Gab-Flores/OTW_FUTUREENGINEERS2025/Team Photos/Team Shot3.jpg

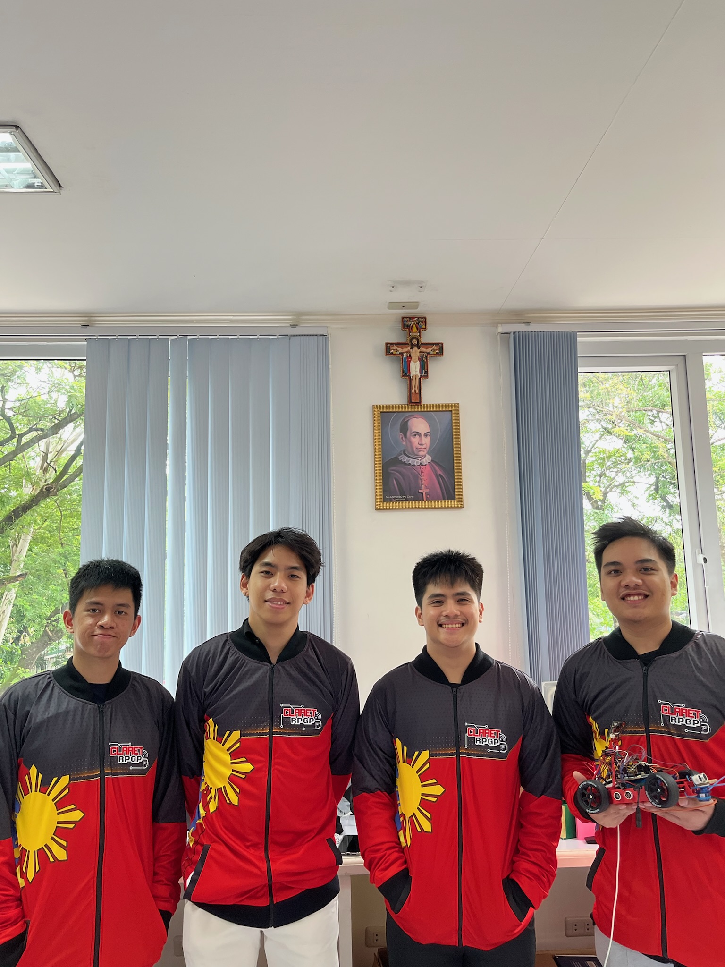
Team Photos/Team Shot3.jpg
