Gab-Flores/OTW_FUTUREENGINEERS2025/Vehicle Photos/Back.jpg

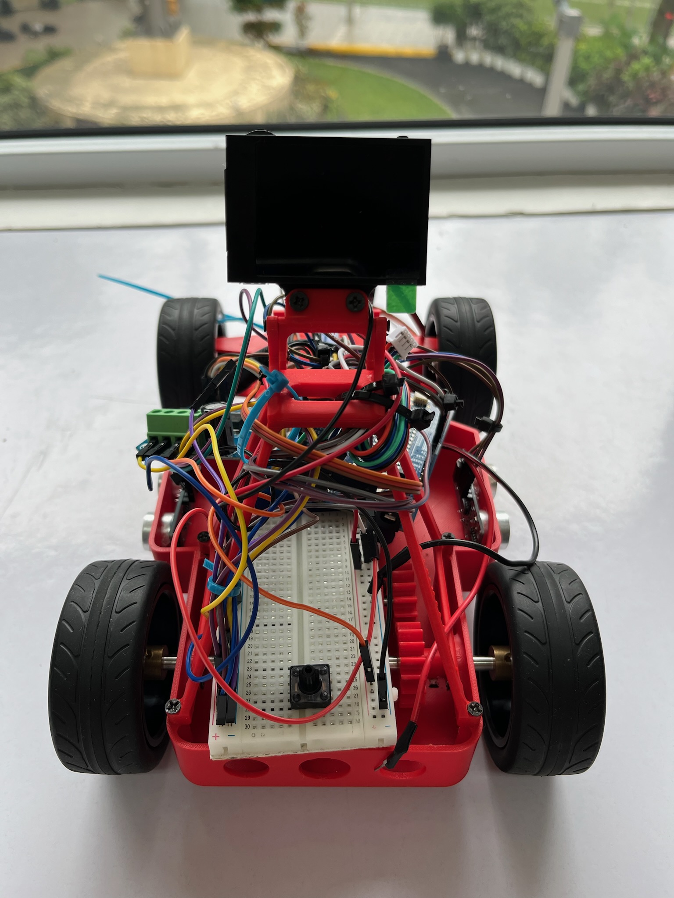
Vehicle Photos/Back.jpg
