Gab-Flores/OTW_FUTUREENGINEERS2025/Schemes/Circuit Diagram Team OTW.png

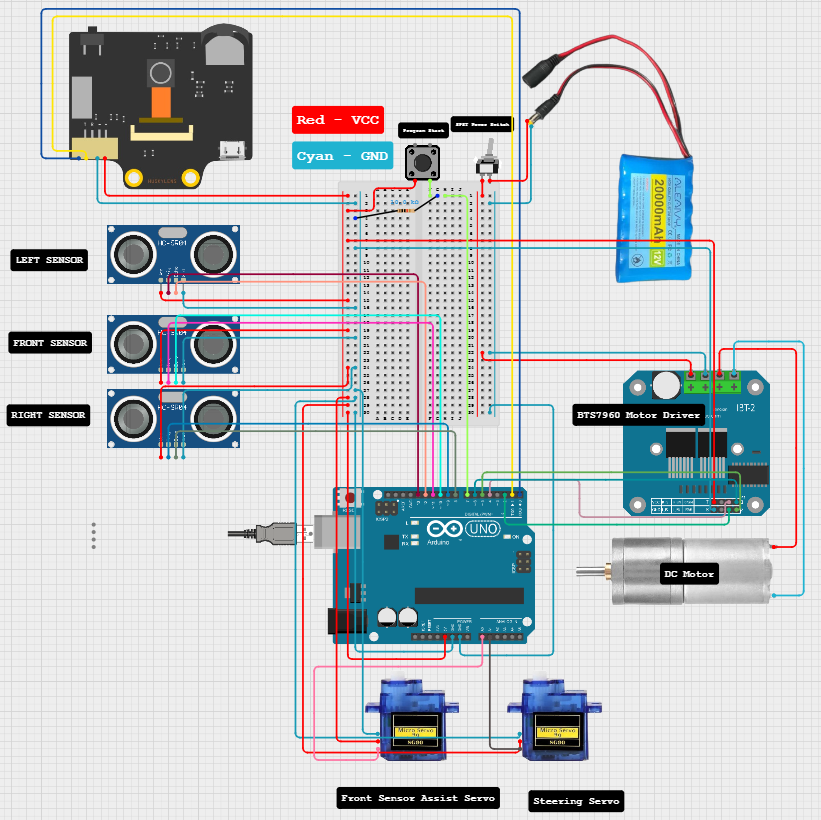
Schemes/Circuit Diagram Team OTW.png
