Gab-Flores/OTW_FUTUREENGINEERS2025/Team Photos/Funny Shot.jpg

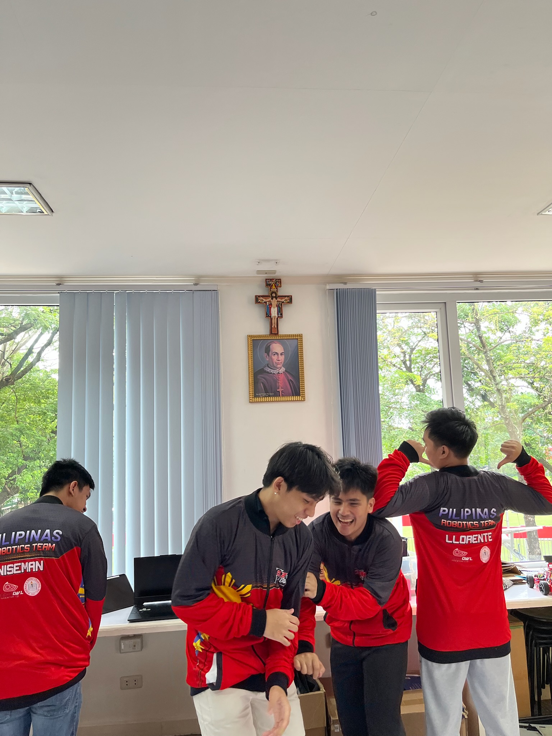
Team Photos/Funny Shot.jpg
