Gab-Flores/OTW_FUTUREENGINEERS2025/Team Photos/Team Shot1.jpg

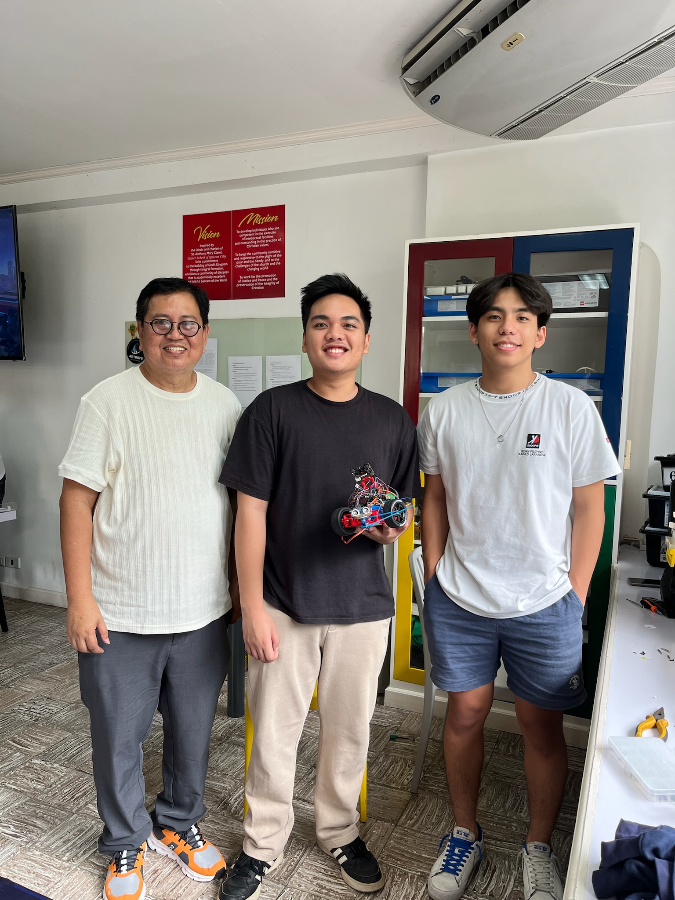
Team Photos/Team Shot1.jpg
