Gab-Flores/OTW_FUTUREENGINEERS2025/Team Photos/Team Shot2.jpg

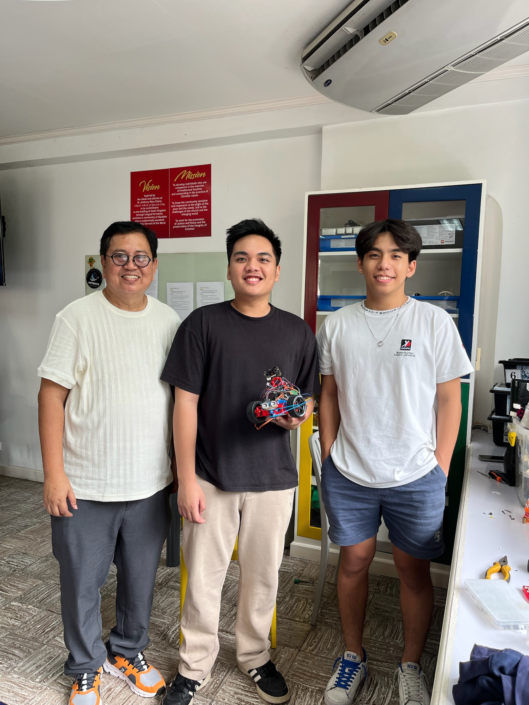
Team Photos/Team Shot2.jpg
