Gab-Flores/OTW_FUTUREENGINEERS2025/Vehicle Photos/Bottom.jpg

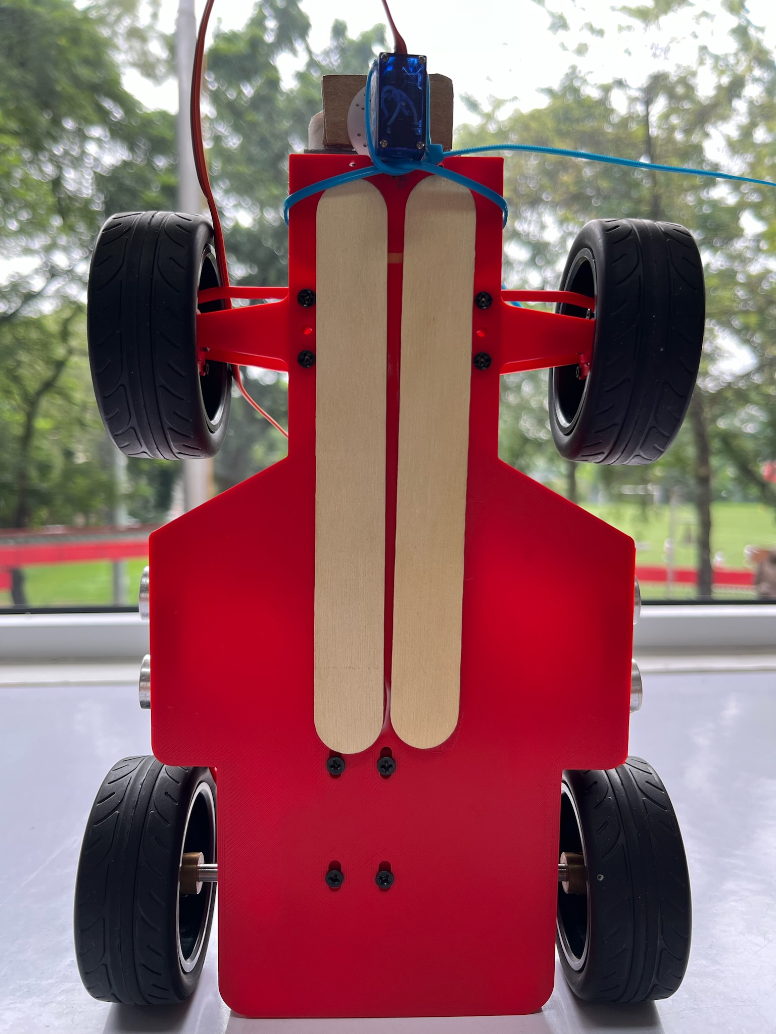
Vehicle Photos/Bottom.jpg
