Gab-Flores/OTW_FUTUREENGINEERS2025/Vehicle Photos/Front.jpg

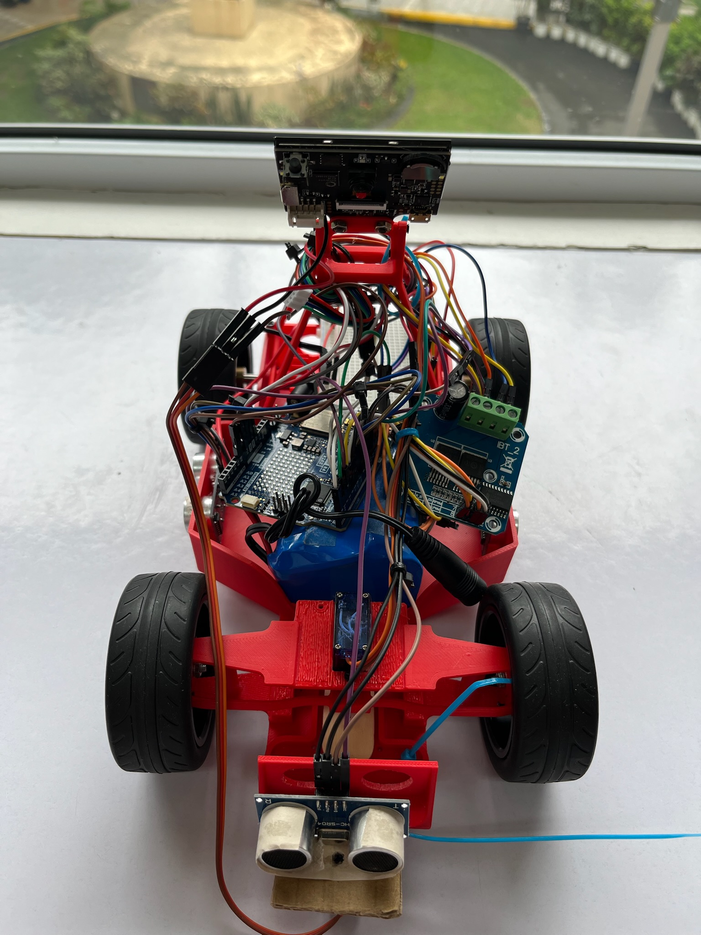
Vehicle Photos/Front.jpg
