Gab-Flores/OTW_FUTUREENGINEERS2025/Vehicle Photos/Left.jpg

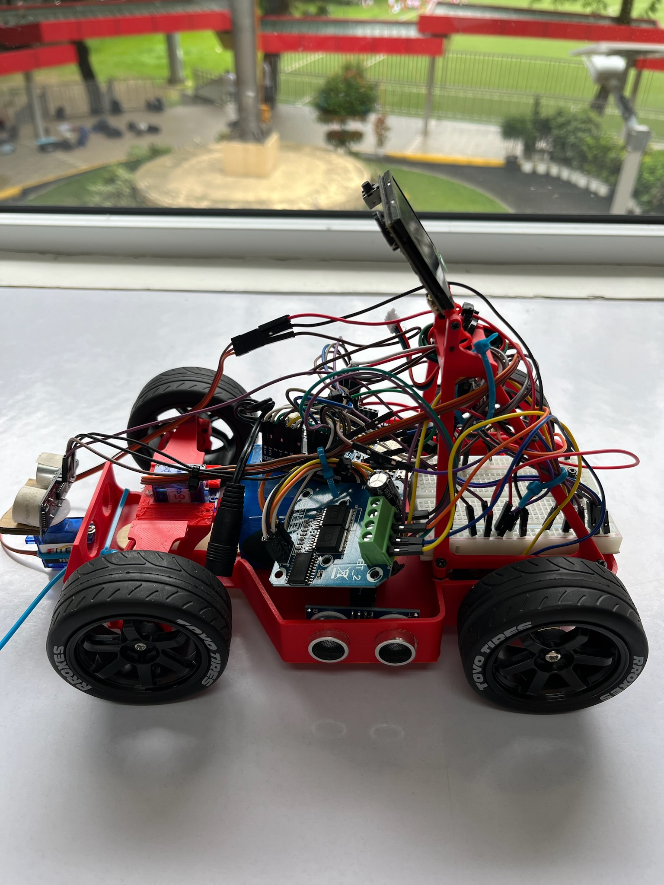
Vehicle Photos/Left.jpg
