Gab-Flores/OTW_FUTUREENGINEERS2025/Vehicle Photos/Right.jpg

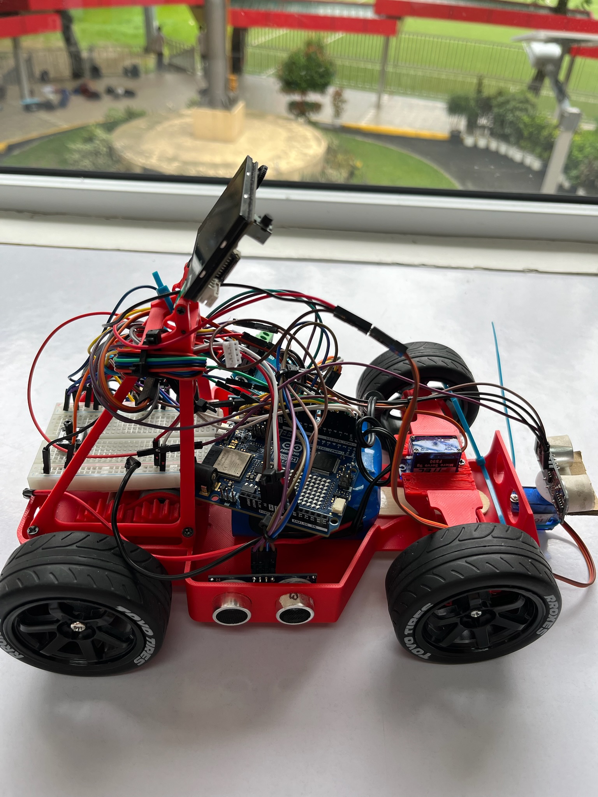
Vehicle Photos/Right.jpg
