Gab-Flores/OTW_FUTUREENGINEERS2025/Vehicle Photos/Top.jpg

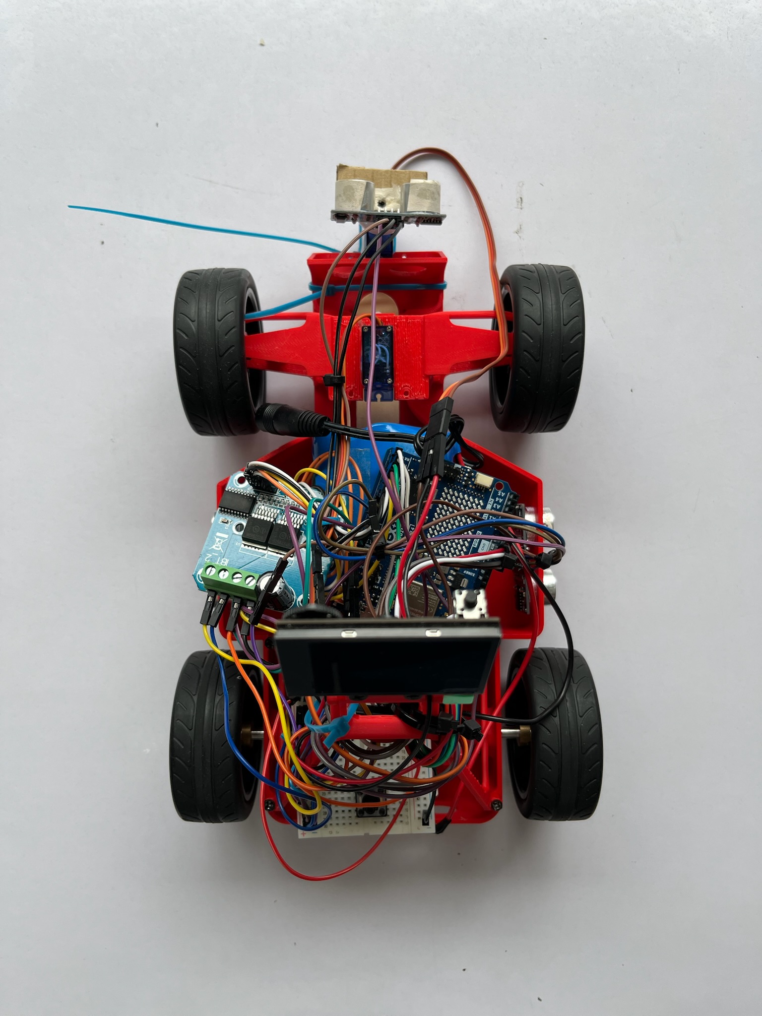
Vehicle Photos/Top.jpg
